nishakm/blinkybracelet/README.md

# blinkybracelet
A bracelet with blinking LED lights

## 29 April 2017
This is more of a learning project than something that can be used and modified. Nevertheless, anyone is free to clone this project and reuse the code for driving charlieplexed LED matrices.
