nishakm/blinkybracelet/basic_bangle.fcstd

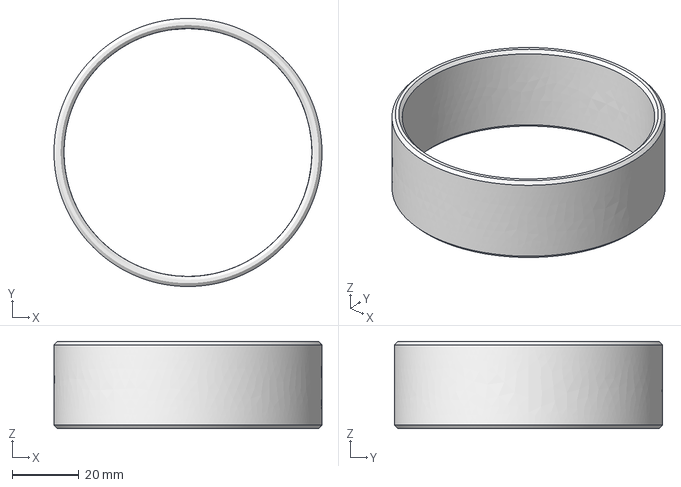
[picture p1: CAD file, 2017-07-30]
basic_bangle.fcstd
80.0 x 80.0 x 26.0 mm
