nishakm/blinkybracelet/(list of files, cad)

Other CAD files:
basic_bangle.stl
