nishakm/blinkybracelet/banglet/eaglecad/dc5032018banglet.brd

## EAGLE design banglet/eaglecad/dc5032018banglet.brd (2018-07-11)

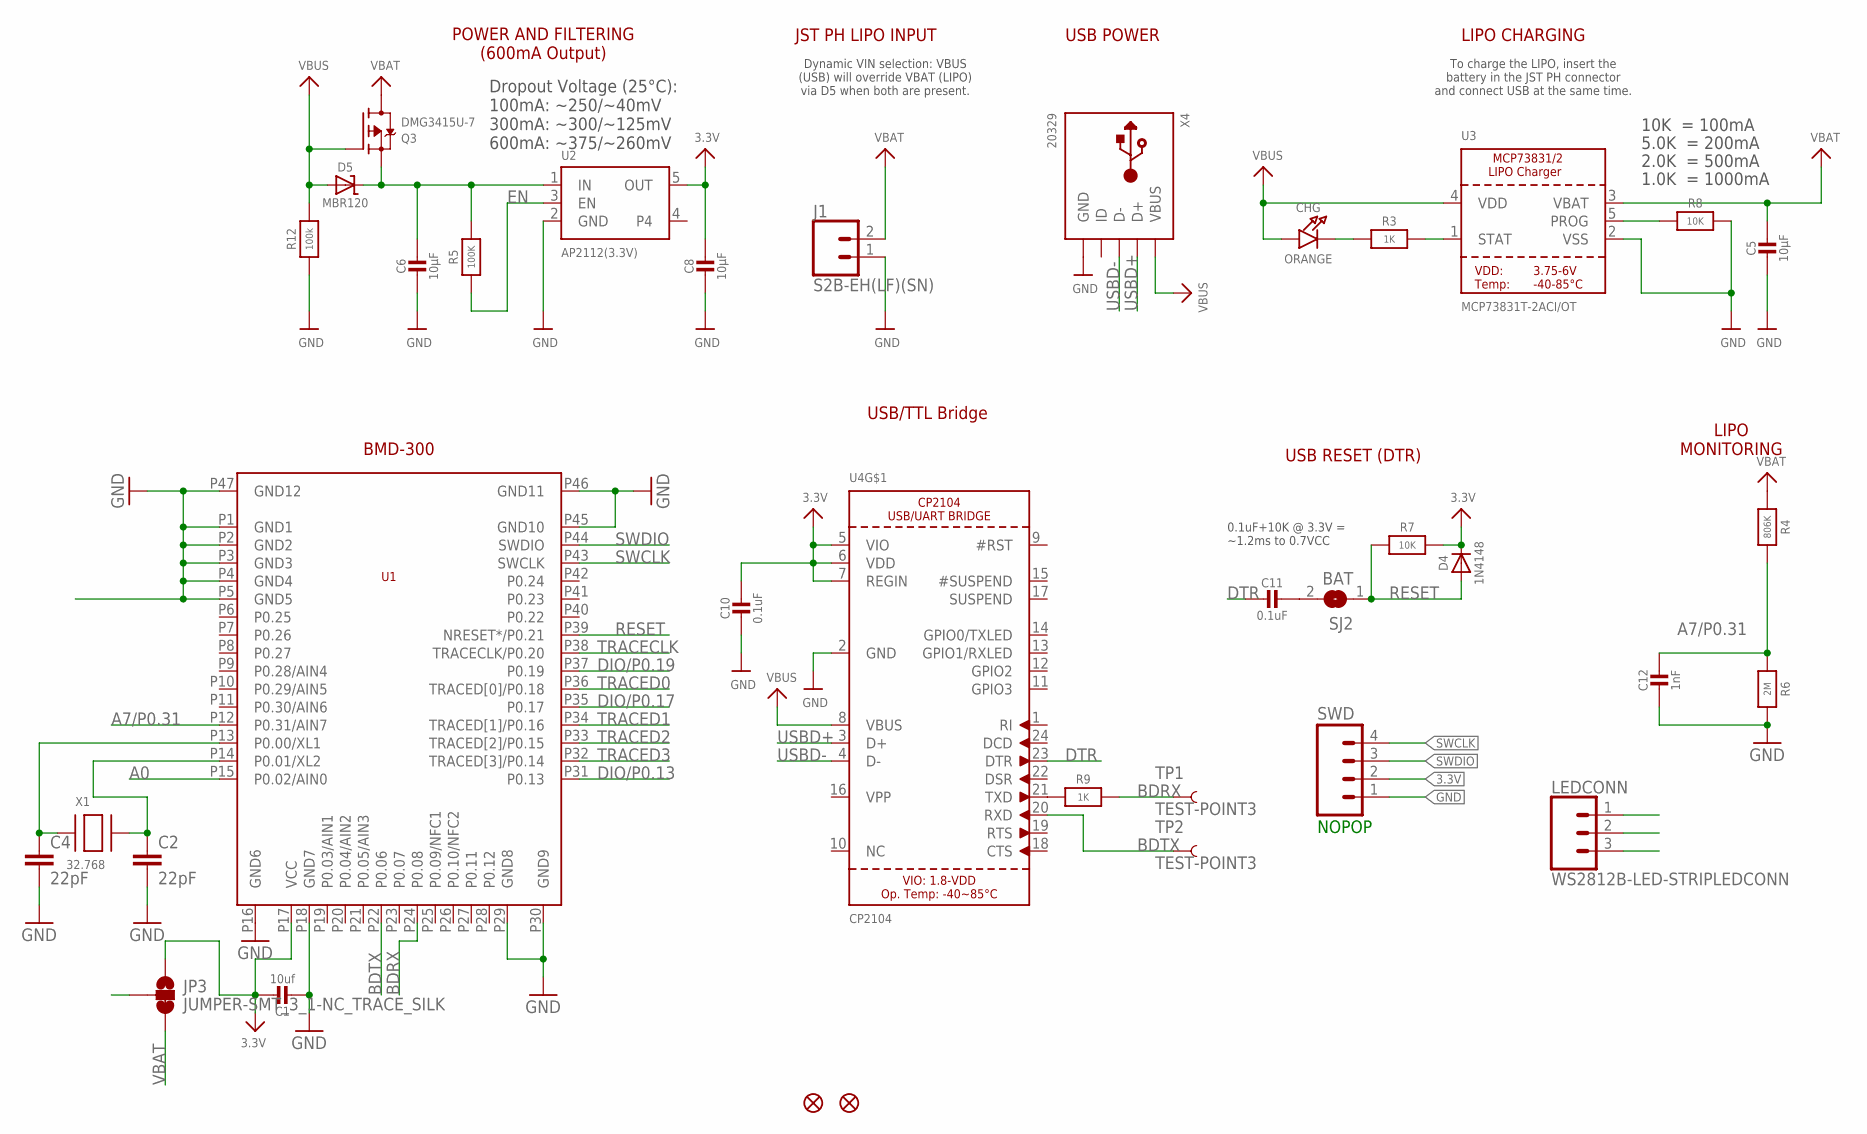
[picture p2: schematic dc5032018banglet.sch]

Parts:
C1: 10uf; 0805-NO
C2, C4: 22pF; 0603
C5, C6, C8: 10µF; 0805-NO
C10, C11: 0.1uF; 0603-NO
C12: 1nF; 0603-NO
CHG: ORANGE; CHIPLED_0805_NOOUTLINE
D4: 1N4148; SOD-323
D5: MBR120; SOD-123
FD1, FD2: FIDUCIALUFIDUCIAL; FIDUCIAL-MICRO
J1: S2B-EH(LF)(SN); 1X2(2.5)
JP3: JUMPER-SMT_3_1-NC_TRACE_SILK; SMT-JUMPER_3_1-NC_TRACE_SILK
LEDCONN: WS2812B-LED-STRIPLEDCONN; 1X3(2.5)
Q3: DMG3415U-7; SOT23-R
R3, R9: 1K; 0603-NO
R4: 806K; 0603-NO
R5: 100K; 0603-NO
R6: 2M; 0603-NO
R7, R8: 10K; 0603-NO
R12: 100k; 0603-NO
SJ2: BAT; SOLDERJUMPER_CLOSEDWIRE
SWD: M04LOCK; 1X04_LOCK@1
TP1, TP2: TEST-POINT3; PAD.03X.03
U1: BMD-300
U2: AP2112(3.3V); SOT23-5
U3: MCP73831T-2ACI/OT; SOT23-5
U4: CP2104; QFN24_4MM_SMSC
X1: 32.768; XTAL3215
X4: 20329; MICRO-USB5+6P-SMD-0.65-B

Connections:
3.3V: C1.1, C8.1, C10.1, D4.C, JP3.1, R7.2, SWD.2, U1.P17 (VCC), U2.5 (OUT), U4.5 (VIO), U4.6 (VDD), U4.7 (REGIN)
A0: LEDCONN.2, U1.P15 (P0.02/AIN0)
A7/P0.31: C12.1, R4.2, R6.1, U1.P12 (P0.31/AIN7)
BDRX: R9.2, TP1.P$1, U1.P24 (P0.08)
BDTX: TP2.P$1, U1.P22 (P0.06), U4.20 (RXD)
DIO/P0.13: U1.P31 (P0.13)
DIO/P0.17: U1.P35 (P0.17)
DIO/P0.19: U1.P37 (P0.19)
DTR: C11.2, U4.23 (DTR)
EN: R5.1, U2.3 (EN)
GND: C1.2, C2.2, C4.2, C5.2, C6.2, C8.2, C10.2, C12.2, J1.1, LEDCONN.3, R6.2, R8.2, R12.1, SWD.1, U1.P1 (GND1), U1.P2 (GND2), U1.P3 (GND3), U1.P4 (GND4), U1.P5 (GND5), U1.P16 (GND6), U1.P18 (GND7), U1.P29 (GND8), U1.P30 (GND9), U1.P45 (GND10), U1.P46 (GND11), U1.P47 (GND12), U2.2 (GND), U3.2 (VSS), U4.2 (GND), X4.5 (GND), X4.S1 (GND), X4.S2 (GND), X4.S3 (GND), X4.S4 (GND), X4.S5 (GND), X4.S6 (GND)
unnamed: C2.1, U1.P14 (P0.01/XL2), X1.P$2
unnamed: C4.1, U1.P13 (P0.00/XL1), X1.P$1
unnamed: CHG.C, R3.1
unnamed: R3.2, U3.1 (STAT)
unnamed: R8.1, U3.5 (PROG)
unnamed: R9.1, U4.21 (TXD)
unnamed: C11.1, SJ2.2
RESET: D4.A, R7.1, SJ2.1, U1.P39 (NRESET*/P0.21)
SWCLK: SWD.4, U1.P43 (SWCLK)
SWDIO: SWD.3, U1.P44 (SWDIO)
TP: U4.THERM (TP)
TRACECLK: U1.P38 (TRACECLK/P0.20)
TRACED0: U1.P36 (TRACED[0]/P0.18)
TRACED1: U1.P34 (TRACED[1]/P0.16)
TRACED2: U1.P33 (TRACED[2]/P0.15)
TRACED3: U1.P32 (TRACED[3]/P0.14)
USBD+: U4.3 (D+), X4.3 (D+)
USBD-: U4.4 (D-), X4.2 (D-)
VBAT: C5.1, J1.2, JP3.3, Q3.3 (D), R4.1, U3.3 (VBAT)
VBUS: CHG.A, D5.A, Q3.1 (G), R12.2, U3.4 (VDD), U4.8 (VBUS), X4.1 (VBUS)
VIN: C6.1, D5.C, Q3.2 (S), R5.2, U2.1 (IN)
VLED: JP3.2, LEDCONN.1

Notes on the sheet:
POWER AND FILTERING (600mA Output)
Dropout Voltage (25°C): 100mA: ~250/~40mV 300mA: ~300/~125mV 600mA: ~375/~260mV
JST PH LIPO INPUT
Dynamic VIN selection: VBUS (USB) will override VBAT (LIPO) via D5 when both are present.
USB POWER
10K = 100mA
5.0K = 200mA
2.0K = 500mA
1.0K = 1000mA
LIPO CHARGING
To charge the LIPO, insert the battery in the JST PH connector and connect USB at the same time.
LIPO MONITORING
USB RESET (DTR)
0.1uF+10K @ 3.3V = ~1.2ms to 0.7VCC
USB/TTL Bridge
NOPOP
BMD-300

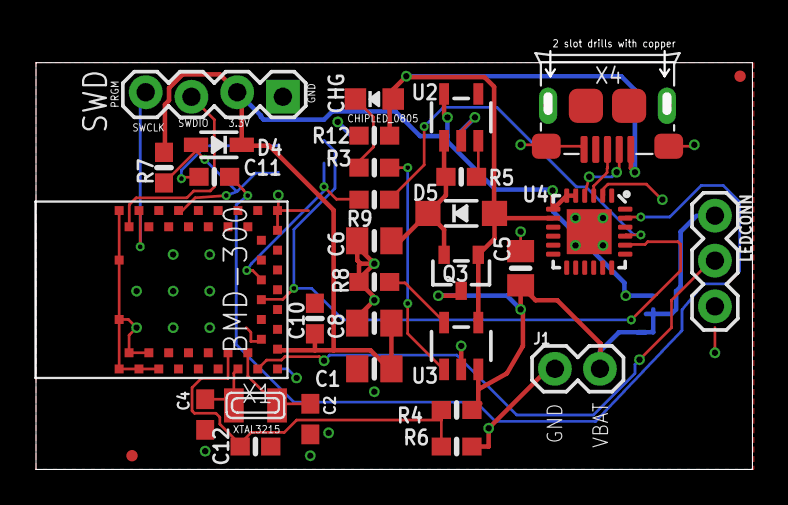
[picture p3: board dc5032018banglet.brd from above]

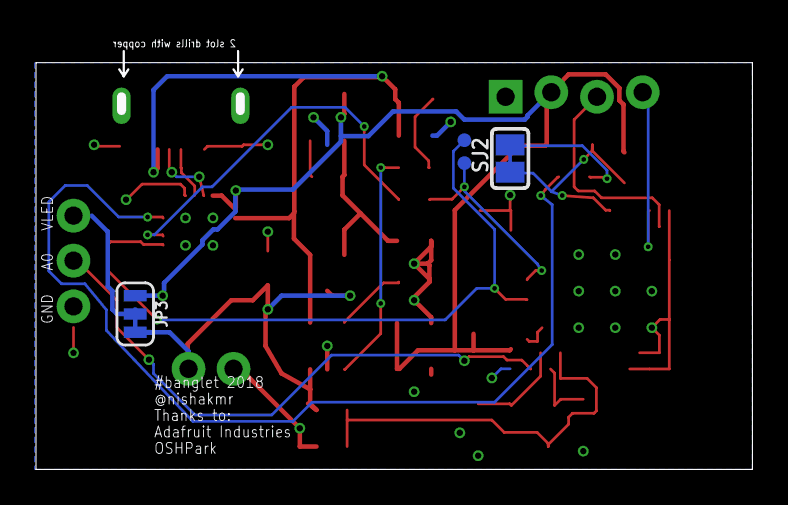
[picture p4: board dc5032018banglet.brd from below]

Board: 2 copper layers, 39.8 x 23.2 mm, 36 parts (4 on the bottom side), 24 nets.
