nishakm/blinkybracelet/(commit log)

2016-09-05 Initial Arduino Uno sketch
2016-12-27 Added A unit test sketch
    - Blink one LED on pin 9
    - Blink one LED on pin 9 but connect it to pin
    10 rather than GND and drive pin 10 low
    - Blink two LEDs on pin 9 and pin 10 by pulling
    one up and pulling the other down
    - Blink a 2x2 LED matrix by pulling up and down
    one row while setting the leftover row to a high
    impedence state. This is called 'Charlieplexing'
2016-12-31 Added unit test for charlieplexed LEDs
    The 2x2 LEDs are charlieplexed meaning that
    they are easily addressed one by one but
    cannot be turned on together
    In order to turn them on together, they
    need to be flickered. Meaning they have
    to be turned off and on quickly to make
    it look like they are being turned on
    simultaneously.
    The results are quite good for 4 LEDs
2017-01-02 Sketch can now turn on any combination of LEDs
    This still uses a 2x2 matrix but can be expanded
    to add more.
    Right now, there is only one combination it can
    turn on and it is hardcoded.
2017-01-03 Random LEDs turn on
    Turns on a random number of LEDs
    It creates a list of LED numbers from 1 to 4
    of random length
    Also, corrected an error with the looping over
    the array of LEDs to turn on
    [sketch_blinkybracelet.ino]
2017-01-03 Added different loops for different number of LEDs
    From observation it seems that pinMode setup takes up
    a lot of time and increases based on how many LEDs
    are turned on. Turning on 1 LED of course is the
    fastest by far.
    There is a Serial console statement to tune the delay
    based on the number of LEDs. These should be removed
    once tuning is done as it seems to affect the
    responsiveness of the LEDs when they flicker
    It doesn't look that good
    [sketch_blinkybracelet.ino]
2017-01-03 Light up a group of LEDs in random combinations
    The 2x2 LED matrix will not light up a random
    number of LEDs in random positions
2017-01-13 Now driving 30 LEDs
    It requires a little work
    Some of the LEDs that I thought I was turning on don't turn on
2017-04-29 Adjust LEDs and loop timings
2017-04-29 Added a smaller set of LED rows
    This one does not have the "leakage"
    on other LEDs
    [sketch_blinkybracelet_3x2.ino]
2017-07-30 Defcon bangle files
    Note: I have not included the Adafruit libraries because according
    to their LGPL license restrictions, I do not know for certain where their
    source files come from, whether they are version controlled, whether
    they have a release process etc. So I want to be very very careful here.
    I got the library from here: https://github.com/adafruit/Adafruit_NeoPixel
    More specifically, I used their download link here:
    https://github.com/adafruit/Adafruit_NeoPixel/archive/master.zip
    I don't know what commit this came from (perhaps it's hidden somewhere
    in their docs. To use the library, mkdir libraries under quickndirty and
    unzip the library there. Then follow instructions here:
    htt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
    [basic_bangle.fcstd, basic_bangle.stl]
2018-06-07 Added WIP files for DC503 Banglet project
    - Added current state of banglet arduino sketch
    (which will probably be completely redone)
    - Added Rev 1 of the Eaglecad board and schematic files
    for the banglet BLE board
    [dc5032018banglet.brd, dc5032018banglet.sch]
2018-06-07 Connect the unconnected; add in a junction
    [dc5032018banglet.brd, dc5032018banglet.sch]
2018-06-08 connect uart tx/rx to bmd-300
    [dc5032018banglet.brd, dc5032018banglet.sch]
2018-06-08 changed layout to perhaps better/easier routing. Routed.
    Opinions saught.
    [dc5032018banglet.brd, dc5032018banglet.sch]
2018-06-09 add 2 fiducials
    [dc5032018banglet.brd, dc5032018banglet.sch]
2018-06-10 removed NFC parts; deleted stray silk
    silk still a mess. I *think* I got all the stray labels.
    [dc5032018banglet.brd, dc5032018banglet.sch]
2018-06-10 move X2; extend planes to dimension
    [dc5032018banglet.brd]
2018-06-10 fix overlap of nc pads with vbat
    [dc5032018banglet.brd]
2018-06-10 move .1uF to next to nrf
    [dc5032018banglet.brd]
2018-06-11 Moved labels so they're clear
    [dc5032018banglet.brd]
2018-06-11 remove some vias under bmd-300 move vias close to bmd-300 pads further away fix shorting of net with solder jumper make usb data line not quite right angle Make a0 a little less close to pads
    [dc5032018banglet.brd]
2018-06-11 make label for LED strip a little clearer
    Move two vias away from bmd pads
    [dc5032018banglet.brd, dc5032018banglet.sch]
2018-07-07 Removed cap and replaced JST connector with vias
    VPP on the UART is for a one time ROM programming of the UART
    which we don't need, so removing it.
    We were unable to find batteries that came with the JST female
    connectors that went with the used board mounted connector.
    Replacing it with vias to use with either board mounted breakaway
    header or something else which will fit.
    [dc5032018banglet.brd, dc5032018banglet.sch]
2018-07-08 Simplify vbat due to through hole.
    tent vias
    [dc5032018banglet.brd]
2018-07-08 Add banlet lib with 2.5mm part and use as J1
    [dc5032018banglet.brd, dc5032018banglet.sch]
2018-07-11 Added new part for LED strip connection
    - Added new part to banglet library
    - Replaced vias for the LED strip with new part
    Eaglecad refuses to name the vias after the nets in the schematic
    [dc5032018banglet.brd, dc5032018banglet.sch]
2018-07-11 connect led header in schematic and board
    [dc5032018banglet.brd, dc5032018banglet.sch]
